wangjiacheng121/pendulum-gravity-measurement/assets/photos/产品实物图.jpg

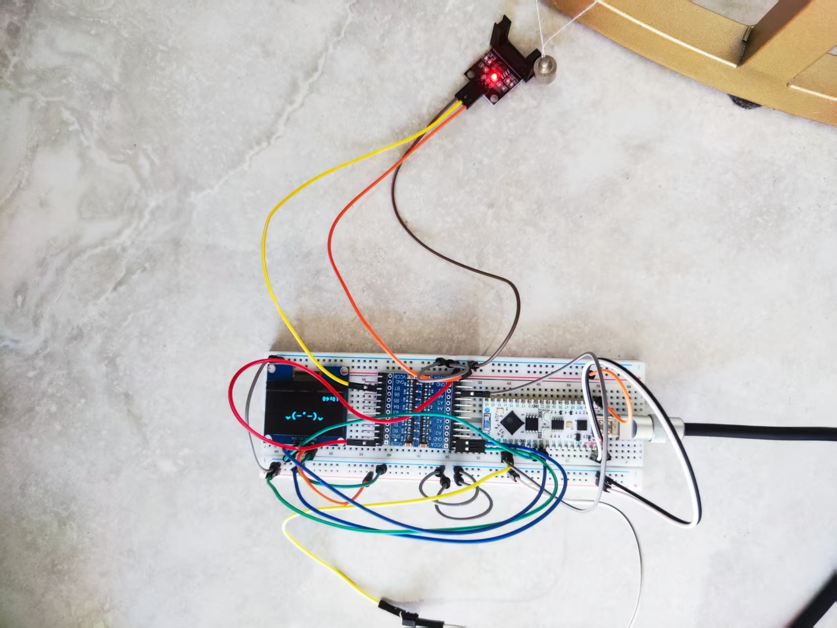
assets/photos/产品实物图.jpg
