wangjiacheng121/pendulum-gravity-measurement/assets/photos/天气-风速.jpg

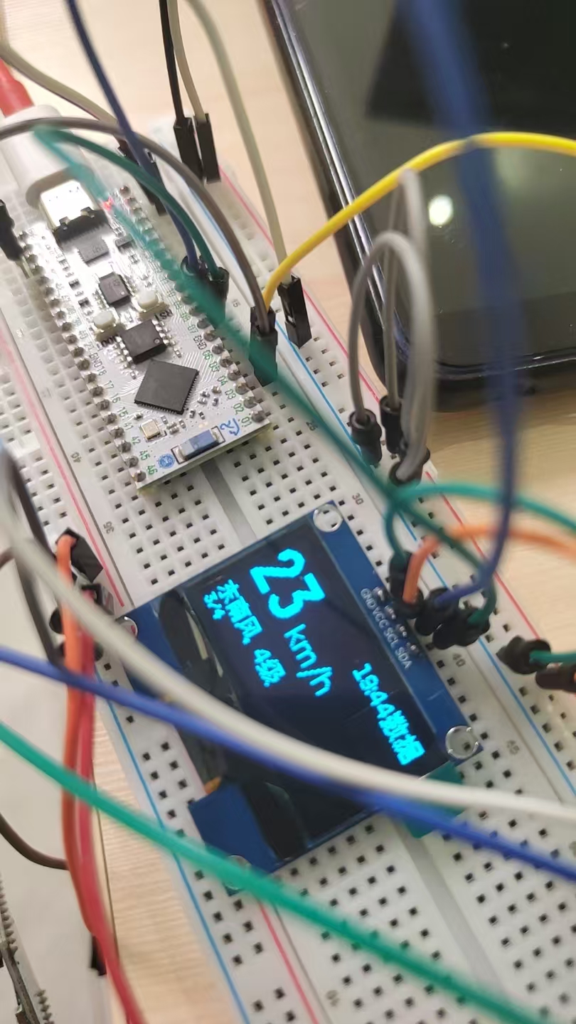
assets/photos/天气-风速.jpg
