wangjiacheng121/pendulum-gravity-measurement/hardware/3D打印外壳图纸（嘉立创X树脂免费打样）.html

# 3D打印外壳图纸（嘉立创 X 树脂免费打样版）

配套项目：单摆测重力加速度（ESP32S3 + 1.3" 屏 + 按键 + Type-C） | 生成日期：2026-10-06 | 建模方式：参数化脚本 enclosure/model_enclosure.py（全部在 E 盘，零 C 盘占用）

### 结论速览

方案 | 件数 | 单件包围盒 | 单件体积 | ≤100mm | ≤70cm³ | 组装难度 | 所需免费券
A 两分体（沿长度中缝对半） | 2 | 86×72×70 | 79.0 / 82.8 cm³ | ✓ | ⚠ 超 13~18% | ★ 最易（1 条缝） | 2 张（若订单页体积校验通过）
B 平板分件（6 面板按 ≤100mm 拆 10 块） | 10 | 最大 86×70×3 | 12.6 ~ 18.1 cm³ | ✓ | ✓ | 中（多缝胶接） | 5 张（每月助力可领）

建议：下单时先上传方案 A 的 2 个 STL，看订单页体积校验是否放行（X 树脂免费券不同时期限额不同，港澳站公示为 ≤150cm³）。若提示体积超限，改用方案 B（10 块全部双达标，按下面分组分 5 单下）。

## 一、总体尺寸与坐标系

项目 | 尺寸 (mm)
外尺寸 | 172 (X 前后) × 72 (Y 左右) × 70 (Z 高)
内腔 | 166 × 66 × 64
壁厚 | 3
顶板 / 底板 | 166 × 66 × 3（内腔投影，嵌于四壁之间）
前 / 后板 | 172 × 70 × 3（通长，厚 3）
左 / 右板 | 66 × 70 × 3（嵌于前后板之间）

坐标约定：X=0 为前面板外表面，Y=0 为左，Z=0 为底；面板之间为对接（无重叠），角部正好严丝合缝。

## 二、开孔明细（含孔位假设，请核对）

开孔 | 所在板 | 孔尺寸 | 定位方式 | 说明
1.3" 屏幕口 | 顶板（左半） | 36 × 35，R2 | 孔中心距顶板左边 32、距顶板前边 33 | 顶板左/前边指与左墙/前墙相接的边（全局 X=3 / Y=3 处）
按键杜邦过孔 ×2 | 顶板（左半） | Φ3.5 通孔 | 间距 2.54（杜邦标准），中心与屏幕口对齐，距顶板前边 10 | 两个公对母杜邦线分别穿过，按键置于壳外
Type-C 口 | 右板 | 9.5 × 3.8，R1.5 | 孔边缘距右板前边 33、距底边 15 | 9.5 沿水平方向，3.8 沿高度方向

⚠ 孔位假设说明（重要）： ① 屏幕口"距左 32 / 距前 33"若按孔边到板边计算，则 32+35=67 > 顶板宽 66，会切穿板边——因此按孔中心定位（中心距边 32/33），刚好居中偏前，与实物布局一致；若你实测屏幕模块位置不同，改脚本里 SCR_CX/SCR_CY 重跑即可。 ② 按键过孔位置为合理假设（屏幕正前方），可在脚本 BTN_Y 处调整。 ③ Type-C 口按孔边缘定位（33/15 均可放下，无冲突）。

## 三、方案 A：两分体（推荐优先尝试）

沿 X=86（长度正中）把壳体切成左右两个"开口托盘"，各含半截前/后墙 + 一整面端墙 + 半块顶/底板。两件对缝用 502 或环氧胶接即成完整壳体。

图 1 方案 A 分体示意（俯视）：沿 X=86 切成两个开口托盘

零件 | 文件 | 包围盒 (mm) | 体积 | ≤100×100×100 | ≤70cm³
左托盘（含屏幕口+按键孔） | stl/shell_left_tray.stl | 86 × 72 × 70 | 79.03 cm³ | ✓ | ✗ 超 9.03
右托盘（含 Type-C 口） | stl/shell_right_tray.stl | 86 × 72 × 70 | 82.75 cm³ | ✓ | ✗ 超 12.75

适用条件：X 树脂免费券若按 ≤150cm³（港澳站公示口径）则两件可直接免单；若订单页校验按 ≤70cm³ 拦截，请改用方案 B。

## 四、孔位图纸

### 4.1 顶板俯视图（166 × 66，下边 = 前面）

图 2 顶板孔位（对应零件 fp_top_L / 左托盘顶板部分）

### 4.2 右板视图（66 宽 × 70 高，左边 = 前面）

图 3 右板 Type-C 孔位（对应零件 fp_right / 右托盘右墙）

## 五、方案 B：平板分件（严格满足 ≤70cm³）

6 块面板中 4 块超长（166/172 > 100mm），各沿 X=86 一分为二，共 10 块平片，对接胶接。每块都是简单平板，打印成功率高、无支撑或极少支撑。

# | 零件 | 文件 | 尺寸 (mm) | 体积 (cm³) | 开孔

1 | 前面板·左 | fp_front_L.stl | 86 × 3 × 70 | 18.06 | —
2 | 前面板·右 | fp_front_R.stl | 86 × 3 × 70 | 18.06 | —
3 | 后面板·左 | fp_back_L.stl | 86 × 3 × 70 | 18.06 | —
4 | 后面板·右 | fp_back_R.stl | 86 × 3 × 70 | 18.06 | —
5 | 底板·左 | fp_bottom_L.stl | 83 × 66 × 3 | 16.43 | —
6 | 底板·右 | fp_bottom_R.stl | 83 × 66 × 3 | 16.43 | —
7 | 顶板·左 | fp_top_L.stl | 83 × 66 × 3 | 12.61 | 屏幕口 + 按键孔×2
8 | 顶板·右 | fp_top_R.stl | 83 × 66 × 3 | 16.43 | —
9 | 左板 | fp_left.stl | 3 × 66 × 70 | 13.86 | —
10 | 右板 | fp_right.stl | 3 × 66 × 70 | 13.76 | Type-C 口

### 下单分组建议（每券限 2 款 × 1 件、总体积 ≤70cm³）

订单 | 零件 | 合计体积 | 合规
第 1 单 | 前面板·左 + 右 | 36.12 cm³ | ✓
第 2 单 | 后面板·左 + 右 | 36.12 cm³ | ✓
第 3 单 | 顶板·左 + 右 | 29.04 cm³ | ✓
第 4 单 | 底板·左 + 右 | 32.86 cm³ | ✓
第 5 单 | 左板 + 右板 | 27.62 cm³ | ✓

每月可通过邀请助力领取 1 张免费券（首次无条件领 1 张），5 张券分 5 个月打完；也可先打顶板+右板（含全部开孔）验证孔位，再打其余。

## 六、嘉立创设计规范核对表

检查项 | 官方要求（X 树脂 / SLA） | 本设计 | 结论
单模型包围盒 | ≤ 100×100×100 mm | A: 86×72×70 B: 最大 86×70×3 | ✓ 全部通过
订单体积 | ≤ 70 cm³（不同时期口径可能为 150） | B 每单最大 36.1；A 单件 79~83 | B 通过 / A 视口径
壁厚 | 推荐 ≥2mm，紧固/卡扣 ≥1.5mm | 全部 3mm | ✓
最小孔径 | ≥1.5mm（喷油件 ≥2mm） | 最小为按键 Φ3.5 | ✓
孔公差 | 树脂 ±0.3mm（孔收缩变小） | Type-C 9.5×3.8 相对母座 ~8.94×3.26 已留 0.5+ 余量 | ✓
溢料孔 | 封闭空腔需 ≥2.5mm 溢料孔 | 开放壳体，无封闭空腔 | ✓ 不适用
拼接件规则 | 连接杆壁厚 >1.5mm、<10 件、每件 +0.5 元 | 方案 B 为 10 件分单下单，非同文件拼接 | ✓ 不触发加收
一文件一零件 | 强烈建议 | 12 个 STL 每文件 1 零件 | ✓
模型类型 | 机电产品结构件、原创 | 自制项目外壳，参数化原创 | ✓

## 七、装配与使用说明

- 胶接：对接面用 502（快固）或环氧 AB 胶（强度高）。建议先干拼一遍确认孔位朝向，再点胶。装配顺序：前后墙 + 左右墙围框 → 底板 → 顶板（方案 B）；方案 A 直接两托盘对缝胶接。
- 屏幕：1.3" 屏从壳内对准 36×35 R2 窗口，热熔胶/支架固定即可；孔边距约 15mm 有足够粘接面。
- Type-C：孔 9.5×3.8 已含 R1.5 圆角并预留 0.5mm 以上余量；若插头偏紧，用小刀/锉轻扩即可（树脂孔收缩 ≤0.3）。
- 按键：两根公对母杜邦线从顶板 2×Φ3.5 孔穿出，按键置于壳外；孔距 2.54mm 与杜邦插头间距一致。
- 打印摆放：平片类零件以大面朝下（贴热台）打印，变形最小；托盘件开口朝上。
- 修改再生成：所有尺寸/孔位集中在 enclosure/model_enclosure.py 顶部参数区（SCR_CX/SCR_CY 屏幕中心、BTN_Y 按键位置、SPLIT 切缝位置等），改完运行：

cd E:/Users/2026-09-24-18-32-24/enclosure && ./.venv/Scripts/python.exe model_enclosure.py

## 八、文件清单

路径 | 内容
enclosure/stl/shell_left_tray.stl | 方案 A · 左托盘（屏幕口+按键孔）
enclosure/stl/shell_right_tray.stl | 方案 A · 右托盘（Type-C 口）
enclosure/stl/fp_*.stl | 方案 B · 平板分件 10 块
enclosure/外壳STL打包.zip | 以上 12 个 STL 的打包（直接上传嘉立创）
enclosure/model_enclosure.py | 参数化建模脚本（改参数重跑即可）
enclosure/report.json | 尺寸/体积/水密性机检报告

免费打样下单入口：m-3dp.jlc.com → 上传 STL → 材料 X 树脂 → 选择免费券。免费件会有嘉立创生产标识（打在模型内侧平面，不影响外观）。
