wangjiacheng121/pendulum-gravity-measurement/firmware/TaskManagerFirmware/docs/README.md

# 固件文档索引

本目录包含每个程序的独立说明文档。快速导航：

| 文档 | 程序 | 核心内容 |
|---|---|---|
| [程序1-桌宠.md](程序1-桌宠.md) | 桌宠屏保 | 表情状态机 / 事件联动 / AI+RSS 预留 |
| [程序2-单摆测g.md](程序2-单摆测g.md) | 单摆测g | 中点法计时 / 四行布局 / **实时波形 #STREAM 协议** / 原版对照 |
| [程序3-天气.md](程序3-天气.md) | 实时天气 | QWeather v7 / 四屏显示 / 紧凑缓存 / 自动重连 |

## 公共基础设施文档

| 文档 | 内容 |
|---|---|
| [../README.md](../README.md) | 固件总览：环境/文件结构/按键/BLE/已知取舍 |
| [../tools/README.md](../tools/README.md) | PC 端工具：ble_cli（命令行+导出）+ phyphox_stream（实时波形）|
