wangjiacheng121/pendulum-gravity-measurement/tools/mobile-webui/使用说明.txt

pendulum-g 手机端蓝牙终端 · 使用说明
（ble_cli.py 网页版 / HyperOS + Operit 适用 / 2026-10-02）

━━━━━━━━━━━━━━━━━━━━━━━━━━━━━━━━━━
一、包内容（共 3 个文件）
━━━━━━━━━━━━━━━━━━━━━━━━━━━━━━━━━━
  ble_cli_web.html   主工具（网页版蓝牙终端，零依赖，无需安装任何 App）
  启动服务.sh         一键启动本地服务（在 Operit 终端运行）
  使用说明.txt        本文件

━━━━━━━━━━━━━━━━━━━━━━━━━━━━━━━━━━
二、重要原理（30 秒读完，避免走弯路）
━━━━━━━━━━━━━━━━━━━━━━━━━━━━━━━━━━
  Operit 的 Ubuntu 是 chroot/proot 容器，没有蓝牙控制器访问权，
  所以 python + bleak（ble_cli.py）在手机上跑不了，root 也无解。
  本工具改用 Chrome 的 Web Bluetooth：由 Chrome 直接调系统蓝牙，
  Operit 的 Ubuntu 只负责起一个本地网页服务。因此：

  * 必须用 Chrome / Edge 等 Chromium 内核浏览器（小米自带浏览器不行）
  * 必须通过 http://127.0.0.1:8000 打开（直接点开 html 文件不行）

━━━━━━━━━━━━━━━━━━━━━━━━━━━━━━━━━━
三、安装与启动（5 步）
━━━━━━━━━━━━━━━━━━━━━━━━━━━━━━━━━━
  1. 把整个「手机端工具包」文件夹拷到手机存储
     （例如 Download/手机端工具包；若 Operit 终端访问不了
      sdcard 路径，就把文件夹复制进 Operit 工作区目录）

  2. 打开 Operit → 终端（Ubuntu），执行：
        cd /你的路径/手机端工具包
        sh 启动服务.sh
     出现 "pendulum-g 本地服务已启动" 即成功。
     （若提示 python3 不存在：apt update && apt install -y python3）

  3. 打开 Chrome，地址栏输入：
        http://127.0.0.1:8000/ble_cli_web.html
     （服务开着才能访问；可收藏此地址）

  4. 开发板上电。点页面顶部「连接 pendulum-g」，
     在系统弹窗里选中 pendulum-g 设备。

  5. 之后所有操作在「终端」卡片进行，和 PC 版 ble_cli.py
     完全一样——看板子的提示输出，照着输入即可。

━━━━━━━━━━━━━━━━━━━━━━━━━━━━━━━━━━
四、常用操作对照（与 PC 版一致）
━━━━━━━━━━━━━━━━━━━━━━━━━━━━━━━━━━
  看状态        0
  配网          1 → 看WiFi列表输序号 → 输密码
  摆长          2 → 2.1 查看 / 2.2 修改（输值后 y 确认）
  海拔          2 进会话后：alt 500
  历史预览      3 → 3.1
  历史导出      3 → 3.2 → 自动收数+自动下载 Excel+T²-L 图
  历史清空      3 → 3.3 → 输 CLEAR
  天气设置      4 → 4.1 状态 / 4.2 坐标 / 4.3 更新 / 4.4 Key+Host
  切程序        APP 1（桌宠）/ APP 2（单摆）/ APP 3（天气）
  模拟自测      APP 2 → SIM ON（结束 SIM OFF 自动入库）
  实时波形      APP 2 → 点「STREAM ON」→ 板上短按键开始测量
  退出会话      q
  （快捷按钮在终端输入框下方，点一下=自动发送）

━━━━━━━━━━━━━━━━━━━━━━━━━━━━━━━━━━
五、文件去哪了
━━━━━━━━━━━━━━━━━━━━━━━━━━━━━━━━━━
  Excel / CSV / T²-L 图 PNG：手机「下载 / Download」目录
  文件名格式：pendulum_history_时间.xlsx、pendulum_T2L_时间.png

━━━━━━━━━━━━━━━━━━━━━━━━━━━━━━━━━━
六、常见问题
━━━━━━━━━━━━━━━━━━━━━━━━━━━━━━━━━━
  Q: 打开网页提示无法访问？
     启动服务.sh 必须保持运行。终端被关了就重新执行第 2 步。

  Q: 点连接没反应/不支持？
     确认用的是 Chrome；系统设置→应用→Chrome→权限→
     「附近设备」设为允许。

  Q: 扫不到 pendulum-g？
     板子重新上电；确认没被 nRF Connect 等 App 占用。

  Q: 连上但终端没输出？
     随便发一个 0 试试。

  Q: 波形卡顿/断流？
     保持 Chrome 页面在前台；给 Chrome 的省电策略设为「无限制」。
     页面会自动申请屏幕常亮，勿手动锁屏。

  Q: 导出中途断了？
     20 秒收不到数据会自动按已收到的部分保存（和 PC 版一样），
     重新发 3.2 即可重导。

━━━━━━━━━━━━━━━━━━━━━━━━━━━━━━━━━━
七、停止
━━━━━━━━━━━━━━━━━━━━━━━━━━━━━━━━━━
  终端里按 Ctrl+C 停服务；页面点「断开」退蓝牙。
  服务不用时建议关掉（省电）。
