wangjiacheng121/pendulum-gravity-measurement/firmware/TaskManagerFirmware/docs/程序2-单摆测g.md

# 程序2：单摆测g（AppId::PENDULUM）

## 概述

核心物理实验程序——通过光电门中断计时测量单摆周期，计算重力加速度 g，支持历史记录、BLE 配置和**实时波形推送（phyphox 兼容）**。

## 计时法：中点法（2026-09-30 升级，2026-10-03 采集/重建分层）

| 项目 | 说明 |
|---|---|
| 触发方式 | GPIO4 中断 **CHANGE 双沿**（FALLING 进遮挡 / RISING 出遮挡）|
| 计时点 | **遮挡时段中点** = `t_in + (t_out - t_in) / 2` |
| 有效数据 | 相邻中点差 = **半周期** |
| 基准管理 | 首个中点仅建立基准不计数；中点差 >5s 重置基准 |
| 精度 | micros() µs 级计时；临界区 noInterrupts 保护 |

> 详见《02-程序2-单摆测g-中点法修订补丁.md》

### 采集 / 重建分层（2026-10-03 重大改造）

改造前 ISR 一边记时间戳一边做判决并丢弃，导致**丢样不可逆**：门限一旦杀掉样本，
loop 层拿不到任何信息，既无法恢复也无法定位。改造后职责彻底拆开：

| 层 | 位置 | 职责 | 是否丢数据 |
|---|---|---|---|
| **采集层** | `gateISR()` | 只做一件事：把每条边沿（亮/灭）连同时间戳写进环形队列 | **绝不丢弃**（唯一例外：队列溢出会计数上报）|
| **重建层** | `onTick()` | 边沿 → 遮挡片段 → 过零中点，并执行全部纠错 | 剔除的都计数留账 |

因此「每一次光电门亮起或熄灭都被记录为有效数据」在结构上成为保证，
而不是一句承诺 —— `EDGES` 命令可逐条导出原始边沿现场核对。

#### 门限（全部以半周期标尺 hRef 为单位，不用绝对微秒数）

| 门限 | 值 | 含义 | 为何这样取 |
|---|---|---|---|
| `GATE_BLINK_MIN_US` | 20 µs | 电气尖峰下限 | 真实电气毛刺 1–10 µs、真实遮挡 ≥4 ms，20 µs 两侧都是空区 |
| `PEND_MINGAP_REL` | 0.30 × hRef | 相对下限 / 碎片合并判据 | 半周期是本实验唯一时间尺度，远小于它的不是独立摆动 |
| `PEND_OUTLIER_REL` | 0.25 × hRef | 离群删除 | 需容纳光电门偏离最低点带来的 ±8% 快慢交替 |
| `PEND_INT_TOL` | ±8% | 整数倍判定 | 判定「这个间隔里漏了 m−1 次」 |
| `PEND_FIX_TOL` / `MAXK` | ±10% / m≤4 | 系统性倍率纠正 | 只做缩小周期方向（丢样只会让周期变大，方向上无歧义）|

> 绝对微秒门限在 L 可变（0.1–5 m ⇒ 半周期 0.63–4.5 s）的实验里必然要么太松要么太紧，
> 故除电气尖峰外一律改用相对判据。

#### 纠错能力（对应「恢复被舍去的数据 / 删除明显不符合规律的数据」）

| 机制 | 触发条件 | 动作 | 对 g 的影响 |
|---|---|---|---|
| **碎片合并** | 与上一片段间隔 < 0.30×hRef | 判为同一次过零的碎片，中点按时长加权合并，计数不虚增 | 中点=整段几何中心，零偏差 |
| **整数倍恢复** | d ≈ m×hRef（m≥2）| 认定中间漏了 m−1 次，`n` 补 m−1，**时间守恒** | **无影响**（sumHalf 加同一段真实时间）|
| **离群删除** | \|d−hRef\|/hRef > 0.25 | 删单个样本（不删整对，避免配对留空洞）| 剔除异常点 |
| **系统性倍率纠正** | 实测 T ≈ m×理论T（m=2..4）| 按 1/m 折算周期，OLED 挂 `FIXx2` 角标 | 修正 g |
| **摆长疑似错** | 实测 h 与理论 h 偏差 >40% | 标尺回退到理论值，每 2s 串口提示核对单位 | 只提示，不擅自改 L |

> 自动纠正过的 g 一定在屏幕上带 `FIXxN` 角标 —— 让用户知道这个数字被软件折算过，
> 而不是让一个改过的值冒充实测值。摆长填错则**绝不**当成丢样去纠正（会掩盖真因）。

#### 新增命令（串口与 BLE 同语义）

| 命令 | 功能 |
|---|---|
| `GATE` / `GATE RESET` | 采集层体检：边沿数 / 溢出 / 遮挡片段 / 碎片合并 / 剔除 / 各类恢复 |
| `FIX` | 纠错账目：收了多少、剔了多少、恢复了多少、删了多少、纠正了几次，偏差来自丢样还是摆长 |
| `EDGES` | 原始边沿逐条转储（时刻 + 电平），用于验证零丢弃 |

> 排障第一入口仍是 `GATE`：边沿数只增不减、永不判决，
> 因此「硬件到底有没有看到摆动」从此有一个不受任何软件判据影响的纯净答案。

## OLED 四行布局

```
  g=9.812 m/s²          ← 即时 g（最近一个周期）
  n=24  t=2.007s         ← 本次测量累计半周期数 + 最近周期 T
  L=1.000 sG=9.794       ← 摆长 + 当地标准 g
  N=24  G=9.801           ← 本次测量累计半周期数（与 n 同值）+ 平均 G
  err=0.07%              [测量中]     ← 相对误差 + 状态
```

## BLE 菜单

### [2] 摆长 / 波形

| 命令 | 功能 |
|---|---|
| 2.1 | 查看当前摆长 L |
| 2.2 | 修改摆长（0.1–5.0 m，二次确认 y/n）|
| **2.4** | **实时波形：STREAM ON / OFF 切换** |
| q | 退出子菜单 |

> **顶层别名**：`STREAM ON` / `STREAM OFF` 可**不进任何会话直接发送**（PC 波形工具 's' 键即走此路径）；程序2 非活跃时固件拒绝并提示「请长按切到 [2]」，此时客户端本地状态自动回退。

### [3] 历史数据

| 命令 | 功能 |
|---|---|
| 3.1 | 预览最新一条 |
| 3.2 | 导出全部（#EXPORT 协议，PC 端自动存 Excel + 绘 T²–L 图）|
| 3.3 | 清空（需键入 CLEAR 确认）|

### 隐藏命令（摆长会话内）

| 命令 | 功能 |
|---|---|
| `alt 123.4` | 修改海拔高度（米），影响当地标准 g 计算 |
| `altstat` | 快慢交替诊断（判断光电门是否偏离最低点）|
| `GATE` | 采集层体检（边沿/片段/碎片合并/剔除/溢出）|
| `FIX` | 纠错账目（恢复/删除/倍率纠正）|
| `EDGES` | 原始边沿转储（验证零丢弃）|

> `GATE` / `FIX` / `EDGES` 同时是**顶层命令**，不进会话直接发即可。

### 模拟数据（无光电门自测，R5 新增）

> **用途**：未接光电门/摆时，用已知周期的合成数据跑通「测量→计算→导出→PC 绘图」全链路，
> 验证固件与 PC 工具，而非验证物理。
> 2026-10-03 起注入的是**边沿对**（LOW → simBlkUs → HIGH）而非成品样本，
> 与真实硬件走完全相同的采集→重建→纠错路径，因此 SIM 验的是真实代码链路而非绕过它。

| 命令 | 功能 |
|---|---|
| `SIM ON` | 开启模拟数据（自动切到测量中）。默认按 L 与 g=9.80 反算半周期，使测出 Gavg≈9.80，便于核对 |
| `SIM <秒>` | 自定义半周期（0.05–10.0 s），如 `SIM 1.5` |
| `SIM OFF` | 停止模拟并结算（写入一条历史），恢复待机 |

> 前置：必须处于 [2] 单摆测g 前台（onTick 仅在活跃程序运行）。无按键时可用系统调试命令
> `APP 2` 经 BLE 切换（走 Manager 正规 activate 路径，与长按等价；见下）。开启后配合 `STREAM ON` 可测 PC 波形端到端。

### 系统调试命令（R5 新增，fw_ble 顶层）

| 命令 | 功能 |
|---|---|
| `APP <1\|2\|3>` | BLE 远程切换程序（调试用；设计上切程序本应只走按键长按，此命令为无按键调试开放，生命周期钩子完整触发） |

## 实时波形功能（phyphox 兼容）

### 启动条件（全部满足才推送）

1. 程序2 为当前活跃程序
2. 处于测量中状态（已按短键开始）
3. BLE 已连接
4. 客户端已发送 `STREAM ON`

### 协议

```
客户端 → 固件:  STREAM ON
固件 → 客户端:  #STREAM BEGIN
固件 → 客户端:  #STREAM 1,2007000,2.007000,9.8123,9.8012,24,1.000
固件 → 客户端:  #STREAM 2,2010000,2.010000,9.7826,9.7965,25,1.000
              ...
客户端 → 固件:  STREAM OFF
固件 → 客户端:  #STREAM END
```

### 字段定义

| 字段 | 类型 | 示例 | 说明 |
|---|---|---|---|
| seq | int | 1 | 帧序号（单调递增）|
| dt_us | int | 2007000 | 半周期原始值（µs）|
| T | float | 2.007000 | 周期 T = 2 × halfT（秒）|
| g_inst | float | 9.8123 | 即时 g = 4π²L/T² |
| g_avg | float | 9.8012 | 平均 g = 4π²L/Tavg² |
| n | int | 24 | 累计半周期数 |
| L | float | 1.000 | 当前摆长（m）|

### 自动停止条件

- 客户端发送 `STREAM OFF`
- 测量结束（用户再按短键停止）
- 切换到其他程序（长按）
- BLE 断连

### PC 客户端

```bash
cd tools
python phyphox_stream.py        # 自动扫描连接
# 按 s 开始/停止波形
# 按 e 导出 CSV
# 按 q 退出
```

详见 `tools/README.md` §工具二

## NVS 键

| 键 | 类型 | 默认值 | 说明 |
|---|---|---|---|
| app2.pend_len | double | 1.000 | 摆长（m）|
| app2.sg_cache | double | 9.794 | 当地标准 g 缓存 |
| app2.sg_src | string | "DEFAULT" | g 来源：DEFAULT（无缓存出厂默认）/ CALC（本地国际重力公式计算，含联网改坐标后重算）|
| app2.sg_ts | int32 | 0 | g 缓存时间戳（epoch）|
| app2.alt_m | double | 0.0 | 海拔（m），影响 g 计算 |
| app2.hist_00..49 | string | — | 历史记录环形区（最多 50 组 CSV）|

## 当地标准 g 计算

国际重力公式：
```
g = 9.780327 × (1 + 0.0053024·sin²φ − 0.0000058·sin²2φ) − 3.086×10⁻⁶ × h
```
- φ = 纬度（默认 40.77° 张家口一中，NVS `sys.loc_lat`）
- h = 海拔（m，NVS `app2.alt_m`）

## 文件

- `app2_pendulum.h` —— 类声明、BleState 枚举、流状态成员
- `app2_pendulum.cpp` —— ISR 中断处理机 / 生命周期 / 测量结算 / BLE 菜单 / 流推送

## 测量误差与操作约束（2026-10-02 数值核算）

### 1. 光电门不在最低点：单次误差大，但快慢成对平均后抵消

设光电门相对最低点水平偏移 x₀，摆幅 ±A，相邻两次过门中点间隔为

```
半周期 = T/2 ∓ (2/ω)·asin(x₀/A)      ω = 2π/T
```

即**一次偏短、一次偏长，符号相反**（L=1 m、振幅 ±5 cm 实算）：

| 偏移 x₀ | 快向半周期 | 慢向半周期 | 单次 g 偏差 | n=2（成对）| n=3 | n=4 |
|---|---|---|---|---|---|---|
| 3 mm | 0.965 s | 1.042 s | +8.1% / −7.2% | **0.00%** | +2.6% | **0.00%** |
| 5 mm | 0.940 s | 1.068 s | +14.1% / −12.3% | **0.00%** | +4.4% | **0.00%** |
| 8 mm | 0.901 s | 1.106 s | +24.1% / −17.7% | **0.00%** | +7.2% | **0.00%** |
| 12 mm | 0.849 s | 1.158 s | +39.8% / −25.0% | **0.00%** | +11.1% | **0.00%** |

**结论：只要 n 为偶数（快慢成对），Tavg 与 g 的偏差理论上为 0。** 固件的
`_sumHalf/_nHalf` 天然满足这一点（每个半周期都入队累加）。

**但有两个真实风险：**

- **n 为奇数或中途丢样本** → 剩余样本不成对，误差直接残留（n=1 时偏 14%）。
  短摆（L=0.1 m，半周期仅 0.32 s）若 OLED 整帧提交拖长 tick 会丢样本，
  务必让 n 停在偶数、或干脆用 T²–L 多点拟合（PC 端 `e2e` 已实现）取斜率。
- **偏移过大（≥ 摆幅）** → 摆球单向通过，光电门每周期只触发一次，
  此时「相邻中点差 = 一个完整周期」，而固件按半周期处理 → g 偏大约 4 倍。
  **务必保证偏移 ≪ 振幅。**

### 2. 有限振幅非线性：真正的系统偏差，与光电门位置无关

| 振幅角 | 横向摆幅(L=1m) | g 偏差 |
|---|---|---|
| 3° | 5.2 cm | −0.034% |
| 5° | 8.7 cm | −0.095% |
| 8° | 13.9 cm | −0.24% |
| 10° | 17.4 cm | −0.38% |
| 15° | 25.9 cm | −0.85% |

近似 −θ₀²/8。**操作要求：横向摆幅控制在 5 cm 以内（≤3°）**，
既保证非线性误差 <0.05%，也保证偏移/振幅比足够小。

### 3. 操作要点

- 光电门装在**最低点**（对不准也要保证偏移 < 5 mm）
- 横向振幅 ≤ 5 cm，不要甩大圈
- 摆长 L 用细线量到**摆球摆心**（含挡光片中心高度）
- 测完一组检查 n：偶数可直接采信，奇数建议重测
- 追求高精度时用 PC 端 T²–L 线性拟合（多点取斜率，单点系统性偏差被摊薄）

## 与原版 Rust 仓库对照

| 维度 | 原版（mcitem/pendulum-gravity-measurement）| 本固件 |
|---|---|---|
| 语言/框架 | Rust + Embassy + esp-hal | Arduino C++ / ESP32 core 3.x |
| 计时法 | 中点法（双沿配对取遮挡中点）| **一致**（2026-09-30 升级对齐）|
| 数据推送 | 自定义 phyphox GATT（f64 notify）| NUS #STREAM 文本协议 |
| 本地历史 | 无 | NVS 50 组环形 + Excel 导出 |
| 当地 g | 无 | 国际重力公式 + 联网缓存 |
| 多程序 | 独立固件 | 任务管理器三程序合一 |

## g 值异常排查：丢样诊断（2026-10-02 新增）

### 现象

用户实测 **g ≈ 1~2**，而理论值 9.794（L=0.425m，张家口）。摆长输入 0.425 正确。

### 数值反推（定位依据）

L=0.425m → 理论半周期 h=0.654s、完整周期 T=1.309s。反推不同 g 对应的 Tavg：

| 实测 g | Tavg | Tavg / T |
|---|---|---|
| 1.0 | 4.096s | 3.13 |
| 1.5 | 3.344s | 2.56 |
| 2.0 | 2.896s | 2.21 |
| **2.448** | **2.618s** | **2.00** |

**g=2.448 恰好等于真实值的 1/4**，正落在用户观测的 1~2 区间。

### 机制

配对逻辑 `_pendHalf + halfT`（两半周期相加 = 一个整周期）**数学本身正确**，
所以 Tavg 偏大只可能是**中点事件丢失**：

```
应有：  h    h    h    h     (每 0.654s 一个事件)
实得：  丢   T    丢   T      (每 1.309s 一个被采纳)
配对：  T + T = 2T = 2.618s，被当作「一个周期」
       → g = 4π²L/(2T)² = 真实g/4 = 2.448
```

丢失率越高 g 越小，故 g 可以低到 1~2。

### 新增诊断计数器

ISR 内五个计数器（`resetMeasure()` 清零），结算时打印：

```
[ Pend ] 丢样诊断: 事件总数=N 入队=M | 短遮挡丢弃=A 过近丢弃=B 超时丢弃=C
[ Pend ] 周期核对: 理论半周期=X s 实测半周期=Y s 比值=R -> 正常/异常
```

| 计数器偏高 | 含义 | 处理方向 |
|---|---|---|
| `短遮挡丢弃` | 遮挡时长 <20ms 被判毛刺（`GATE_DEBOUNCE_US=20000µs`）| 挡光片太窄/摆球太快 → 加宽挡光片至 20mm+，或下调阈值 |
| `过近丢弃` | 相邻中点 <20ms，异常过近 | 存在抖动/双触发 → 检查接线与上拉 |
| `超时丢弃` | 相邻中点 >5s，基准失效 | 摆动中断/停顿，属正常 |
| `事件总数 ≈ 2×入队` | **隔次丢样确认** | 比值 ≈2 即本案 |

比值落在 0.55~1.8 之外时，屏幕弹出「周期异常,疑似丢样」通知。

### 注意

配对机制**不能**修正系统性丢样——它只能消除「快慢交替」和奇偶尾差。
一旦事件按固定倍数丢失，配对会把错误间隔照单全收。

## 上板实测：n 不增长的两个原因（2026-10-02 晚）

### 现象

用户反馈「单摆通过后显示的 n 没有增加，通过数次后才增加」。

### 排查结论：**不是 bug，是操作 + 一个真 bug**

**原因 A（操作）**：必须先**短按开始测量**。待机时 onTick 内 `if (!_measuring) continue;`
会把 ISR 捕获的样本全部丢弃，`n` 恒为 0——这是设计行为（避免待机时摆动把 OLED 拉成 10fps）。
屏幕右下角 `[待机]` / `[测量中]` 是唯一状态标识，容易被忽略。

**原因 B（真 bug，已修）**：L0 屏保在长按切程序后**立刻误触发**，把刚切过去的程序弹回桌宠：

```
[Btn] LONG 802ms fired
[Mgr] activate 单摆测g (4.0ms) reason=long-press     ← 已切过去
[Mgr] L0 screen-saver -> app1                          ← 又被弹回
[Mgr] activate 桌宠 (32.0ms) reason=screensaver
```

根因：`tick()` 开头的 `now` 早于 `handleButton()` 内 `activate()` 末尾的
`_lastInteract = millis()`（activate 要写 NVS + 整帧提交，耗时 1–33ms）。
屏保判据 `(uint32_t)(now - _lastInteract)` 于是**无符号下溢**成 ~4.29e9 > timeout，误判超时。
activate 耗时越长越必然触发（实测 1ms 那次侥幸未中，32ms 两次全中）。

修复（`fw_manager.cpp`）：
1. 屏保检查前用 `now = millis();` 重新取时间（必须在 handleButton 之后）
2. 判据改 `(int32_t)(now - _lastInteract) > (int32_t)_saverTimeoutS * 1000`（环绕安全）
3. 删掉长按分支里多余的 `_lastInteract = now`（activate 已正确赋值，留着反而写入偏旧值）

### SIM 模式验证（串口，排除硬件因素）

新增 `tools/serial_pend_n_test.py`。结果：

```
[ Pend ] 结算: n=33 参与=32(成对16组) Tavg=1.30846 Gavg=9.8000 交替=无 落单1个已排除
[ Pend ] 周期核对: 理论半周期=0.6542s 实测半周期=0.6542s 比值=1.000 -> 正常
```

`n` 24→30→33 持续增长、G=9.8000（err −0.02%）、周期核对比值 1.000 →
**固件测量链路完好**，此前 g≈1~2 与 n 不增长均为上述原因 A/B 所致。

### 新增防呆

待机时若检测到摆动事件，屏幕显示「请短按开始测量」4 秒（限频 1s 刷新，不影响测量态）。
