wangjiacheng121/pendulum-gravity-measurement/assets/photos/单摆测重力加速度实景.jpg

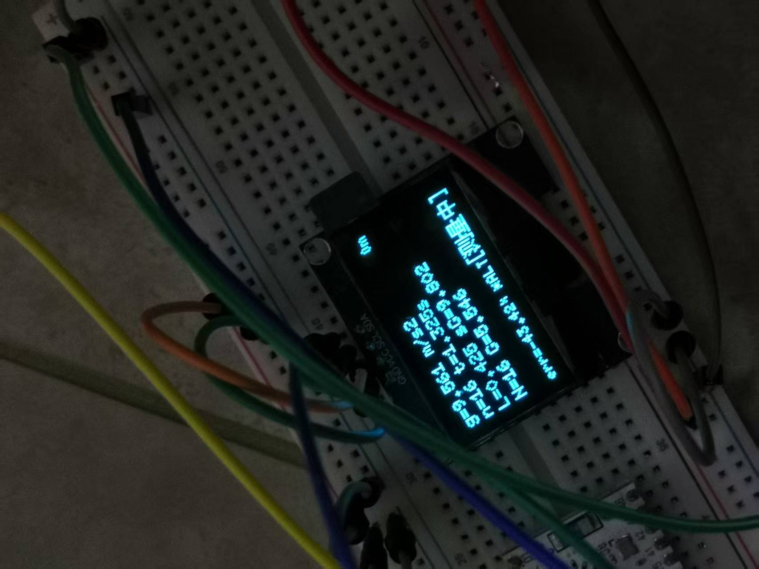
assets/photos/单摆测重力加速度实景.jpg
