wangjiacheng121/pendulum-gravity-measurement/assets/photos/单摆测重力加速度理想数据.jpg

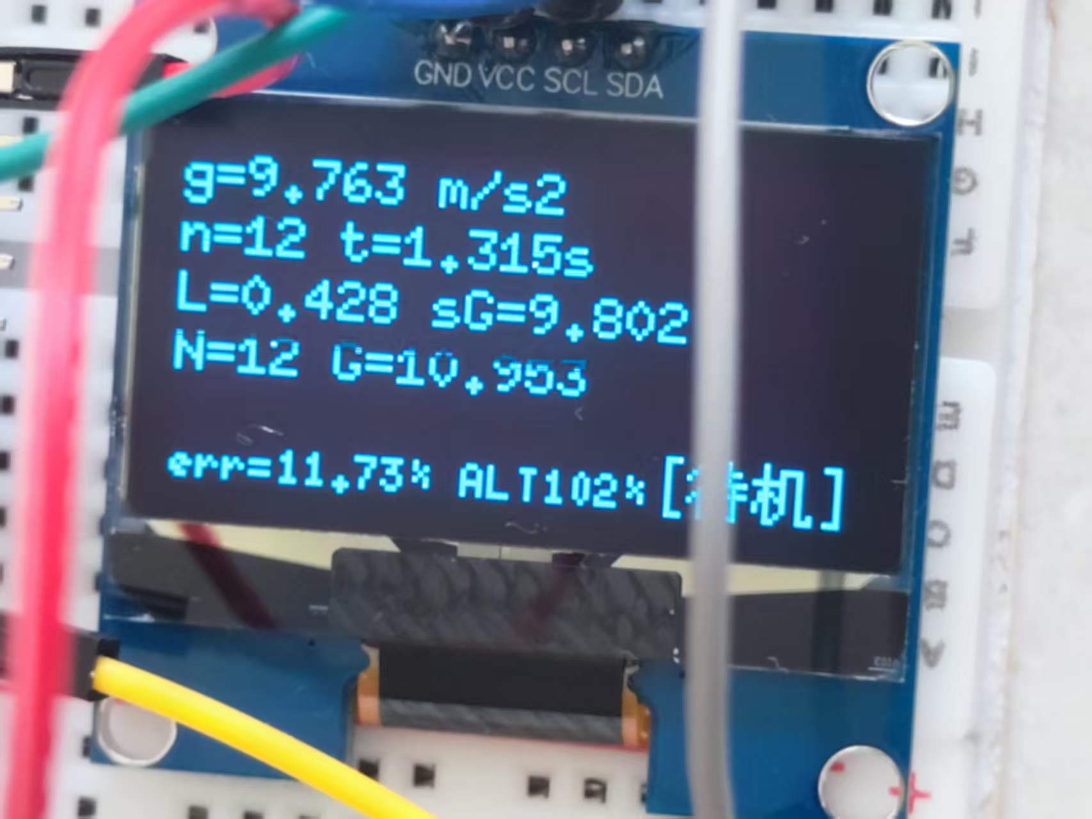
assets/photos/单摆测重力加速度理想数据.jpg
