wangjiacheng121/pendulum-gravity-measurement/assets/photos/天气-温度.jpg

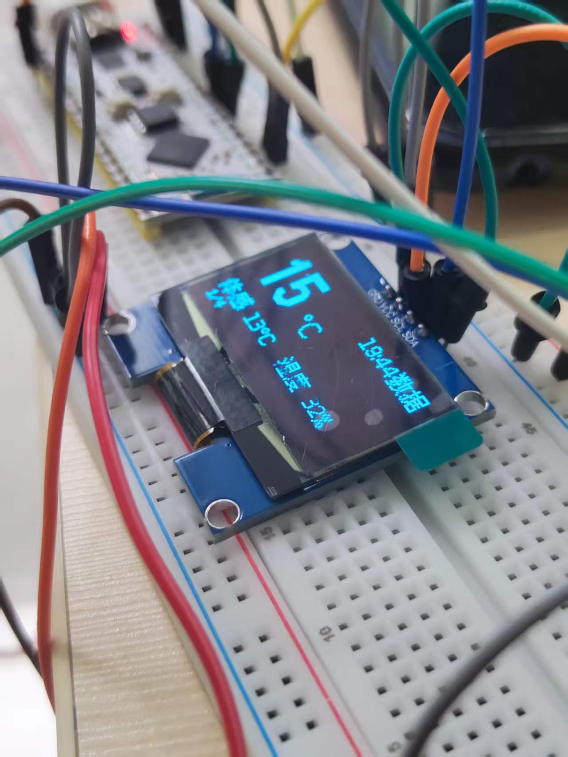
assets/photos/天气-温度.jpg
