wangjiacheng121/pendulum-gravity-measurement/assets/photos/天气-降水.jpg

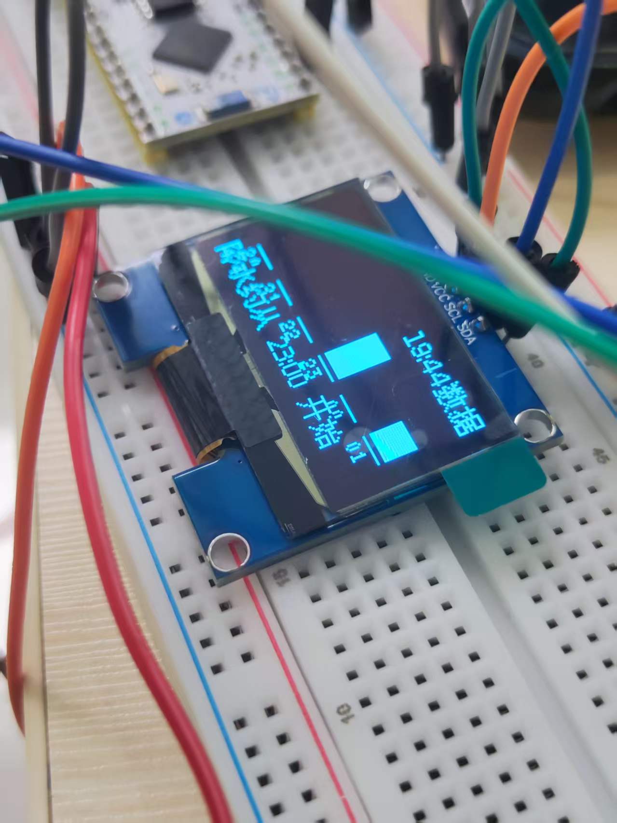
assets/photos/天气-降水.jpg
