wangjiacheng121/pendulum-gravity-measurement/assets/photos/桌宠-打盹.jpg

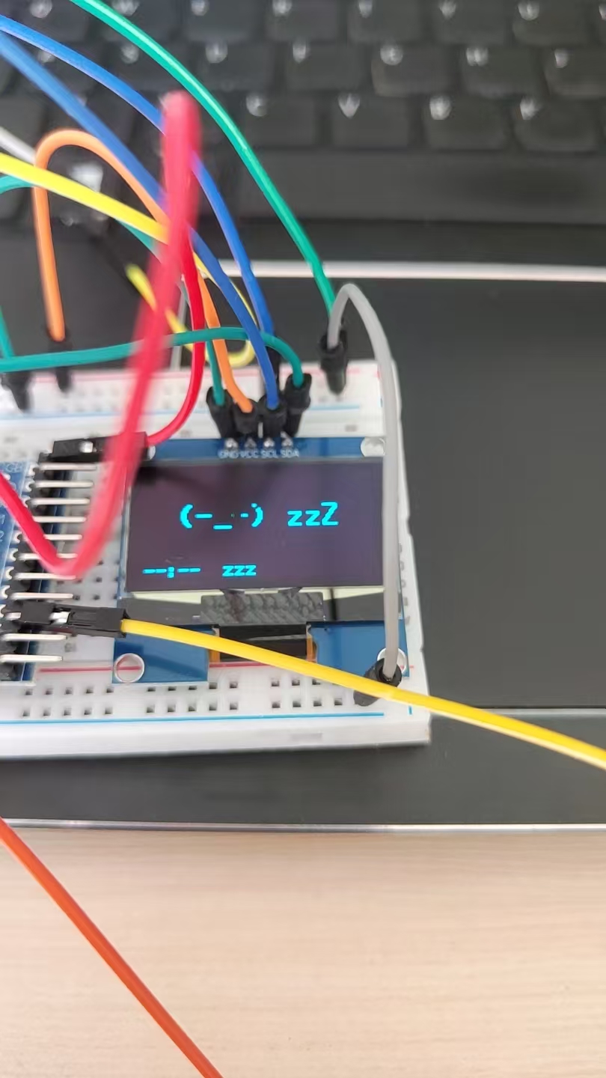
assets/photos/桌宠-打盹.jpg
