wangjiacheng121/pendulum-gravity-measurement/hardware/enclosure/stl/shell_assembled.stl

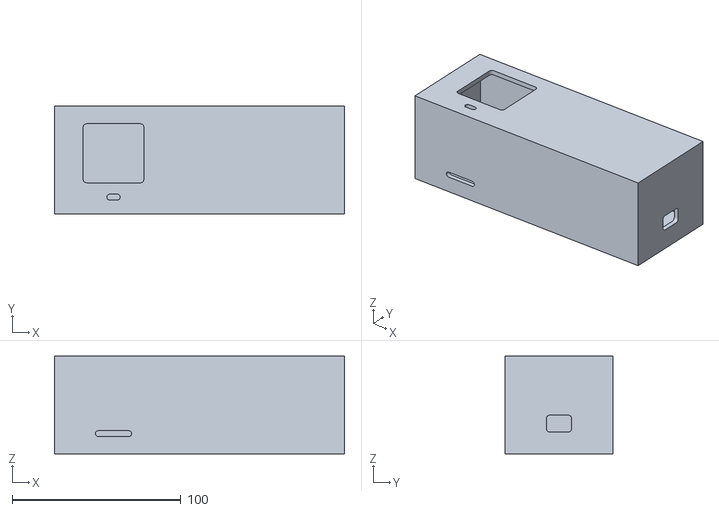
[picture p9: CAD file, 2026-10-17]
hardware/enclosure/stl/shell_assembled.stl
172.0 x 64.0 x 58.0
