wangjiacheng121/pendulum-gravity-measurement/hardware/enclosure/stl/shell_right_tray.stl

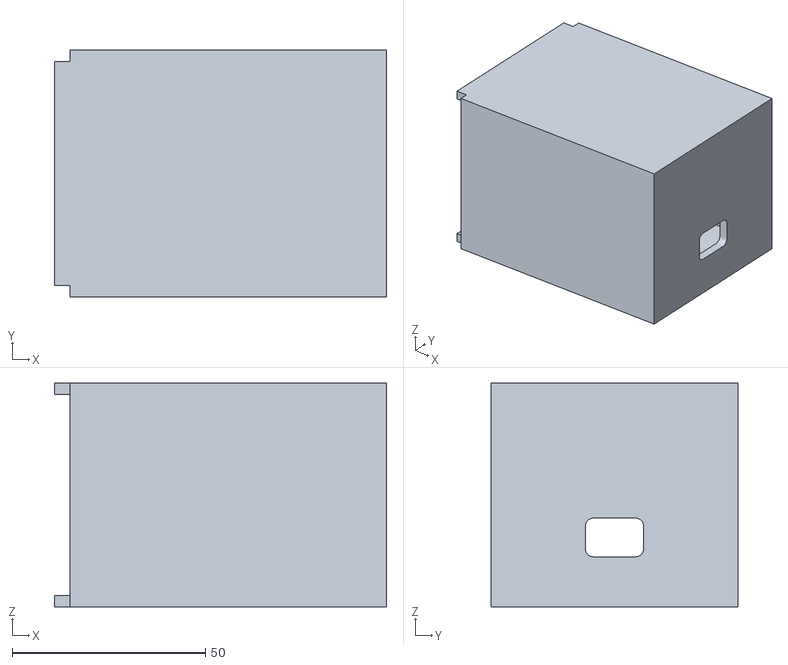
[picture p10: CAD file, 2026-10-17]
hardware/enclosure/stl/shell_right_tray.stl
86.0 x 64.0 x 58.0
