wangjiacheng121/pendulum-gravity-measurement/hardware/enclosure/stl/shell_left_tray.stl

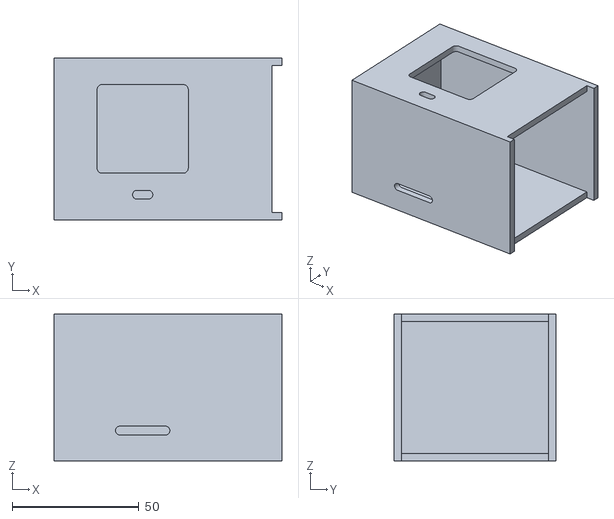
[picture p11: CAD file, 2026-10-17]
hardware/enclosure/stl/shell_left_tray.stl
90.0 x 64.0 x 58.0
