wangjiacheng121/pendulum-gravity-measurement/hardware/enclosure/stl/fp_top_L.stl

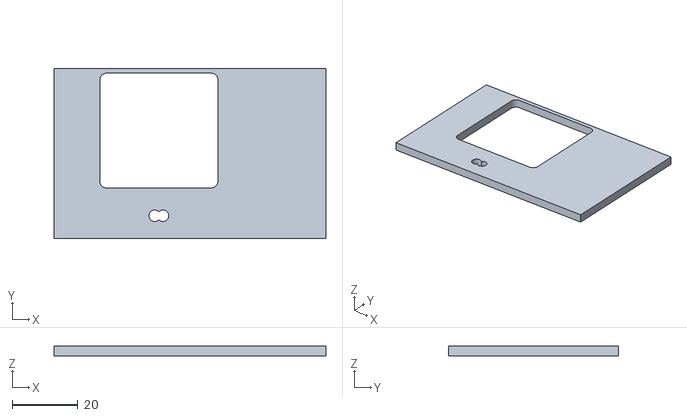
[picture p13: CAD file, 2026-10-17]
hardware/enclosure/stl/fp_top_L.stl
83.0 x 52.0 x 3.00
