wangjiacheng121/pendulum-gravity-measurement/hardware/enclosure/stl/fp_right.stl

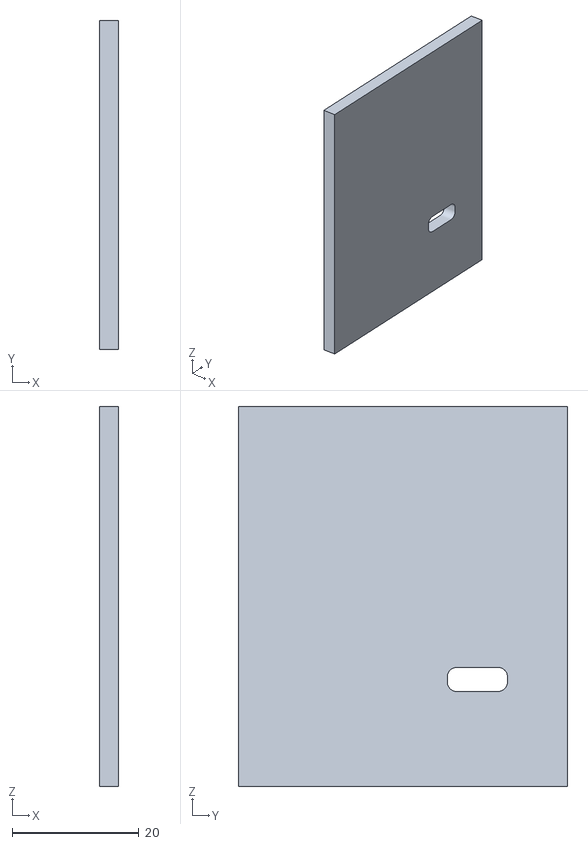
[picture p14: CAD file, 2026-10-17]
hardware/enclosure/stl/fp_right.stl
3.00 x 52.0 x 60.0
