wangjiacheng121/pendulum-gravity-measurement/hardware/enclosure/stl/fp_front_R.stl

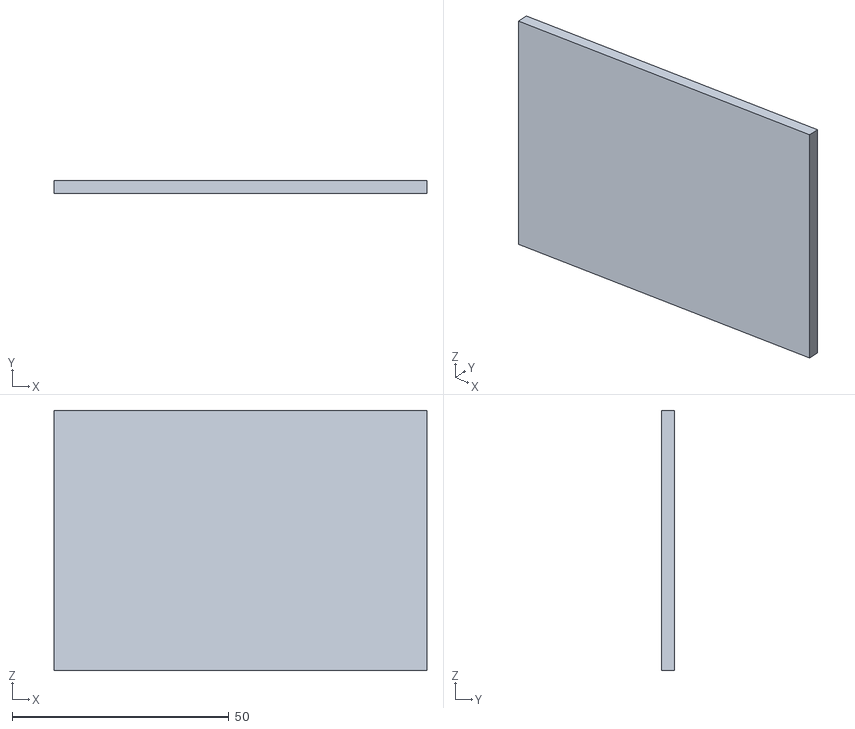
[picture p15: CAD file, 2026-10-17]
hardware/enclosure/stl/fp_front_R.stl
86.0 x 3.00 x 60.0
