wangjiacheng121/pendulum-gravity-measurement/(list of files, cad)

Other CAD files:
hardware/enclosure/stl/fp_left.stl
hardware/enclosure/stl/fp_front_L.stl
hardware/enclosure/stl/fp_bottom_R.stl
hardware/enclosure/stl/fp_bottom_L.stl
hardware/enclosure/stl/fp_back_R.stl
hardware/enclosure/stl/fp_back_L.stl
