wangjiacheng121/pendulum-gravity-measurement/firmware/TaskManagerFirmware/fw_config.h

#pragma once
// =====================================================================
// fw_config.h —— 全局配置（引脚 / 时序常量 / 默认值）
// 依据《00-总纲-架构与硬件协议》
// 注意：天气 Key 改为内置（2026-10-02 用户要求「将 key 写入固件」）。
//       NVS 优先级高于内置值 —— 换账号/换服务只需 BLE [4.4] 覆盖，无需重刷。
// 例外：WiFi「默认回退列表」按用户 2026-09-30 明确要求内置（见下方 WIFI_DEF_*）。
//       这三条属个人私有凭据 —— 若日后公开发布源码/开源仓库，务必先清空！
// =====================================================================

#define FW_VERSION      "1.0.0"
#define FW_NAME         "TaskManagerFirmware"
#define FW_BUILD_DATE   __DATE__ " " __TIME__   // 编译时自动注入构建时间

// ---------- 引脚（总纲第 3 节，实物硬件） ----------
#define PIN_OPTOGATE    4       // 光电门信号（经 BSS138 电平转换，空闲高/遮挡低）
#define PIN_BUTTON      5       // 按键，INPUT_PULLUP，按下=LOW
#define PIN_SDA         8       // I2C SDA
#define PIN_SCL         9       // I2C SCL

// ---------- OLED ----------
#define OLED_ADDR_1     0x3C    // 首选地址（7 位）
#define OLED_ADDR_2     0x3D    // 备用地址

// ---------- 按键时序（总纲第 1 节硬约束） ----------
// 2026-10-02 修订：BTN_LONG_MS 1200→800。
// 原 1.2s 阈值在 loop() 100ms 节拍 + 天气程序 15-25s 阻塞下几乎不可能被采样到，
// 实测长按切程序完全失效。800ms 仍明显长于人手「点一下」的 200-300ms，
// 不会与短按混淆，但长按容错从「几乎做不到」变为「正常可用」。
#define BTN_DEBOUNCE_MS 30      // 软件消抖
#define BTN_LONG_MS     800     // 长按 = 切换程序
#define BTN_SUPER_MS    5000    // 超长按 = 系统重启（预留）

// ---------- 主循环节拍 ----------
// 2026-10-02 拆分两级节拍（长按失效修复）：
//   LOOP_INTERVAL_MS —— loop() 自身节拍，10ms。只为把按键采样率从 10Hz 提到 100Hz：
//                       100ms 采样下一次短按（按下+抬起约 150-250ms）会横跨 2-3 个采样窗，
//                       消抖窗口 30ms 虽能通过，但采样点太少，长按时长判定误差可达 ±100ms。
//   TICK_INTERVAL_MS —— onTick 业务分发节拍，仍为 100ms（≤10Hz，总纲 5.2 契约不变）。
// 二者不可互相替代：onTick 里的 NVS 写入 / 整帧提交 / BLE 分块都是重活，不能提到 100Hz。
#define LOOP_INTERVAL_MS 10
#define TICK_INTERVAL_MS 100    // onTick 分发 ≤10Hz（总纲 5.2 契约）

// ---------- 屏保 / 熄屏（总纲 5.4 省电分级） ----------
#define SCREEN_SAVER_DEFAULT_S 180      // sys.screen_saver_timeout 默认值，0=关闭
#define PET_IDLE_TO_SLEEPY_MS  (5UL*60UL*1000UL)   // 程序1 idle 5min → 瞌睡（L3）
#define PET_SLEEPY_TO_OFF_MS   (60UL*1000UL)       // 瞌睡 1min → 请求熄屏
#define NET_IDLE_DISCONNECT_MS (5UL*60UL*1000UL)   // WiFi 空闲 5min 断开（L2）

// ---------- 默认定位（总纲第 7 节 NVS 表，可经 BLE 修改） ----------
#define LOC_LON_DEFAULT "114.88"        // 张家口一中
#define LOC_LAT_DEFAULT "40.77"

// ---------- 默认 WiFi 回退列表（开源已清空，请填入你自己的网络；见 README） ----------
// 优先级：NVS 用户凭据（BLE 配网 sys.wifi_ssid/pass）> 下方顺序；
// 连接失败（不在范围/认证失败/20s 超时）自动轮换下一个，整轮失败回 IDLE 等外部重试
#define WIFI_CRED_MAX    4              // 列表容量 = 1 条用户凭据 + 3 条默认
// ⚠️ 开源已清空：请改为你自己的 WiFi（或留空，改用 BLE [1.2] 配网写入 NVS）
#define WIFI_DEF_SSID_1  ""
#define WIFI_DEF_PASS_1  ""
#define WIFI_DEF_SSID_2  ""
#define WIFI_DEF_PASS_2  ""
#define WIFI_DEF_SSID_3  ""
#define WIFI_DEF_PASS_3  ""

// ---------- 历史/天气缓存容量 ----------
#define HIST_CAP        50      // app2.hist_00..hist_49 环形区

// ---------- 程序2 单摆测g（分册02） ----------
// 2026-10-03 重大改造：门限从「微秒级」压到「准静态物理级」，采集层零过滤。
// 改造前后的职责划分变了，必须先说清楚，否则又会出现「一个常量管两件事」：
//   采集层（ISR）只做一件事 —— 把 GPIO4 的每一条边沿连同时间戳存进环形队列。
//        零过滤、零丢弃、零门限。亮起和熄灭都被记录，「漏记」在采集层不再可能发生。
//   重建层（onTick）从边沿序列重建「遮挡块 → 过最低点中点」，并在这里做全部纠错：
//        电气尖峰剔除、合并块分裂、丢样恢复、离群删除、系统性倍率纠正。
// 换言之：门限从「决定收不收数据」降级为「决定这条数据算不算一次有效摆动」，
// 两者不再混为一谈。所有原始边沿都可用 EDGES 命令导出核对。
#define GATE_EDGE_RING   1024    // 原始边沿队列深度（2 的幂，ISR 用 & 取模）。
                                  // R7b（2026-10-06）64→1024：实摆光电门信号存在持续振荡
                                  // （实测 75s 灌入 5536 边沿、溢出 3394，突发簇远超 64 深），
                                  // 溢出会把真实摆动边沿一起挤掉 = 「挡光彻底不识别」的元凶。
                                  // RAM 代价 5KB（动态内存余量 272KB，可忽略）。

// 电气尖峰下限：把「微秒级硬件尖峰/振荡碎片段」从重建流程里摘掉。
// R7b（2026-10-06）20µs→200µs：实测振荡环境下 20~200µs 的碎片段仍有大量存活
// （75s 产生 1283 个 <20µs 被剔 + 大量 >20µs 成块），200µs 能把电平转换慢边沿
// 振荡的碎片级翻转全部掐掉。真实遮挡 = 挡光宽度÷过最低点速度，
// 实测 4.7ms（5g 砝码 30°振幅）~ 45ms（15~20mm 硬纸片），对 200µs 有 23 倍裕度。
#define GATE_BLINK_MIN_US    200UL
// —— 宽容模式（R7c，2026-10-06；同日修订：默认启用）——
// R7b 严格门限（BLINK 200µs/STUCK 粘连）在病态信号下会「零产出」：全部片段
// <200µs 被剔 → 0 块 0 样本 → 屏幕无数据（实测：点挡 3s 期间 21 片段全 <200µs）。
// R7c 初版为「30s 零产出自动降级」；用户决策改为**默认即宽容**（实验不允许等待）：
// 片段层常驻宽容值——BLINK 用 GATE_BLINK_MIN_FB_US(20µs，=R7 前旧版值)、
// STUCK 粘连剔除（片段级+合并链级）停用；统计层（相对门限/半样本配对/离群删除）
// 全部保留 = 质量守门员，毛刺假中点由离群删除清理，真摆样本畅通（仿真 S15 实证
// 降级后真摆 G 偏差 +0.00%）。GATE 输出「当前电平/宽容模式」直读行。
// _degraded=true 为常驻状态，将来如需恢复严格模式把 app2_pendulum.h 初值改 false
// 并按 git/R7c 日志恢复触发块。
#define GATE_BLINK_MIN_FB_US  20UL
#define GATE_DEGRADE_REJ      8     // GATE verdict 判「剔除主导」的阈值（rej≥8）
// 相邻中点绝对下限：仅作兜底，正常判定走相对门限（PEND_MINGAP_REL，按 hRef 比例）。
// 半周期 h=π√(L/g)，L 取最小 0.1m 也有 0.63s；2ms 远低于任何物理可能，
// 只用来挡住「同一个块被算出两个中点」这种结构性错误。
#define GATE_MINGAP_US    2000UL
#define GATE_TIMEOUT_US    5000000UL      // >5s 视为基准失效，重置基准不计数

// —— 重建层（onTick）的全部判据，都以「理论/实测半周期 hRef」为标尺 ——
// 片段层合并门限（R7-01，2026-10-06 由 0.30 上调至 0.45）：
//   两次真实过零的片段间隔 = h − 遮挡时长 ≈ 0.9×h，远大于 0.45×h，不会误合并；
//   而「双遮挡」——光路里有两个遮挡物（摆球+挡光片）先后过槽——两块片段的
//   间隔 = Δ − 遮挡时长（Δ ≤ 0.5×h，因两遮挡物间距不可能超过摆长），当 Δ 较小时
//   落在 0.45×h 以内，必须合并成 1 个中点，否则每个真实半周期会产出 2 个假中点，
//   周期被压半 → g 虚增 4 倍（实测定向复现：G=39.3 = 4×9.83）。
//   合并中点 = 两片段按时长加权的几何中心，虽然绝对相位偏移 Δ/2，但「间隔」
//   完全不受影响，对 g 零偏差。
#define PEND_MERGE_REL    0.45
// 粘连块剔除（R7b，2026-10-06 新增）：完整片段时长 > 0.50×hTheo 判「信号粘连/振荡假块」，
// 剔除并计数 _nStuck。实测振荡环境下出现 740ms 的"遮挡块"（真实纸片遮挡仅 15~45ms，
// 是信号贴着阈值慢振荡把 LOW 段拉长数百倍）。物理依据：遮挡时长 = 遮挡宽÷速度，
// 最宽 45mm + 释放起点 3° 的极端组合在 L=0.428m 时也只有 ~154ms，而 0.50×hTheo=328ms，
// 有 2 倍以上裕度；SIM 注入遮挡 = h/20 = 0.05×h，远低于门限。
// 注意：本判据假定 L ≥ 0.4m（本项目实验范围）；L < 0.2m 的大遮挡物慢摆可能被误杀。
#define PEND_STUCK_REL    0.50
// 中点流相对门限：相邻中点差 < 0.30×hTheo 判电气毛刺/抖动，剔除但计数。
// R7-02（2026-10-06）：标尺从 hRef（实测滑均，可被假样本污染）换成 hTheo（理论值，
// 来自 L 与当地 g，恒可靠）。hRef 被污染后用相对门限会「真假一起删」，表现为挡光不计数。
// 半周期是本实验唯一的时间尺度，凡远小于它的都是干扰，没有物理意义。
#define PEND_MINGAP_REL   0.30
// 半样本配对合并（R7-03，2026-10-06 新增）：Δ 较大的双遮挡无法在片段层合并，
// 中点间隔呈 Δ 与 h−Δ 两簇交替（Δ∈(0.45h, 0.8h) 时两簇都保留到中点流）。
// 两簇样本都 < 0.80×hTheo 且彼此之和 ≈ hTheo（±20%）→ 合并为 1 个真样本（时间守恒）；
// 落单的短样本（后继不是短样本 / 和对不上）→ 删除并计数 _nShortDrop。
// 物理约束保证安全：快慢交替的真样本幅度 ≤±8%（都 > 0.8×h，不判短）；
// 两个真样本之和 = 2h ≠ h，天然不满足配对条件。
#define PEND_SHORT_MAX_REL   0.80
#define PEND_SHORT_PAIR_TOL  0.20
// 离群门限：|d − hRef|/hRef > 0.25 判「明显不符合规律」，删除但计数。
// 留 25% 宽容度是因为光电门偏离最低点时相邻半周期会一快一慢（幅度对称），
// 真实数据本身就能有 ±8% 的摆动，必须放得下。
// R7-04（2026-10-06）：去掉「_nHalf>=4 才启用」的门槛 —— 该门槛让开头 4 个样本
// 绕过全部相对判据，双遮挡假中点恰好能在 2 个真实半周期内凑满 4 个 → 污染
// _sumHalf/hRef → 正反馈锁死（真样本反被当离群删除）。hRef 在样本 <3 时本就
// 回退到理论值 hTheo，理论标尺从头到尾可用，无需免检窗口。
#define PEND_OUTLIER_REL  0.25
// 整数倍判定容差：d/hRef 落在整数 k 的 ±8% 内即认定「中间漏掉了 k−1 次」，
// 据此恢复样本计数（时间守恒：sumHalf 加的仍是同一段真实时间，故不污染 g，
// 只修好 n 计数与波形里的真实摆动次数）。
#define PEND_INT_TOL      0.08
// 注：此处曾有 PEND_BLK_SPLIT_RATIO / PEND_SPLIT_MAX 两个「合并块分裂」常量，
// 已随该设计一并删除（详见 app2_pendulum.cpp 碎片合并段的注释与
// tools/selftest_rebuild.py 顶部说明）：那是段永远不触发的死代码，
// 而 LOW 段裂成几片属于「同一次过零的碎片」，应当合并成 1 个中点（PEND_MINGAP_REL 判据）。
// 系统性倍率纠正容差：实测平均周期 / 理论周期 落在整数 m 的 ±10% 内即触发自动纠正。
// 只做单侧（缩小）：丢事件只会让间隔变大，绝不会变小，因此这个方向无歧义；
// 反方向（间隔偏小）在物理上不可能由丢样造成，一律不自动改，只提示检查摆长。
#define PEND_FIX_TOL      0.10
#define PEND_FIX_MAXK     4       // 最多按 4 倍折算（对应「每 4 次漏 1 次」以内）

#define PEND_LEN_DEFAULT   1.000          // app2.pend_len 出厂默认（m）
#define SG_DEFAULT         9.794          // 无缓存时默认标准 g（sg_src=DEFAULT）

// ---------- 程序3 天气（分册03） ----------
// 内置和风天气凭据（2026-10-02 用户要求写入固件，开机即用、无需先配网）
// ⚠️ 个人私有凭据 —— 公开发布源码/开源仓库前务必清空这两行！
//
// Host 请使用你自己在和风天气控制台「设置→凭据管理」获取的账号专属域名
//   （格式如 xxxxx.re.qweatherapi.com，区域码以控制台显示为准）→ 实测 code=200，
//   对应城市实时数据正常，now 与 24h 两接口均通。
// 换账号时无需重刷：BLE [4]→[4.4] 覆盖 NVS 即可（NVS 优先于本值）。
// ⚠️ 开源已清空：请填入你自己的和风天气凭据（或留空，改用 BLE [4]→[4.4] 配置写入 NVS）
#define WX_HOST_DEFAULT ""
#define WX_KEY_DEFAULT  ""
#define WX_PERIOD_MS       (30UL*60UL*1000UL)  // 30 分钟拉取周期
#define WX_RETRY_DELAY_MS  30000UL             // 失败重试间隔（仅重试 1 次）
#define WX_HTTP_TIMEOUT_MS 10000UL             // HTTP 超时 10s

// ---------- 错误码（总纲 8.2 三族；网络族） ----------
#define E_NET_NO_CRED   (-100)   // 未配置凭据
#define E_NET_TIMEOUT   (-101)   // 连接/请求超时
#define E_NET_GZIP      (-102)   // GZIP 解压失败
#define E_WX_PARSE      (-103)   // 天气响应解析失败
#define E_WX_API        (-104)   // 天气 API 返回 code != 200
#define E_WX_HOST       (-105)   // API Host 域名无法解析（2026-10-02 新增：
                                   // 内置 Host 区域码猜错时 httpGet 只回 -1，
                                   // 单独报错才能定位是域名问题而非网络不通。
                                   // 注意 WiFi.hostByName() 对不存在的域名仍返回 true
                                   // 但 IP 为 0.0.0.0 → 必须同时校验 IP 非 0）

// ---------- 事件附加码（Event::code） ----------
#define EVT_NET_LOST_CODE_POWERSAVE 1   // EVT_NET_LOST：L2 空闲主动断电，非故障
                                        // （不标注会让桌宠把「省电断网」误判成掉线而长期 Sad）
