wangjiacheng121/pendulum-gravity-measurement/(commit log)

2026-10-17 add assets/photos/产品实物图.jpg
2026-10-17 add assets/photos/单摆测重力加速度实景.jpg
2026-10-17 add assets/photos/单摆测重力加速度理想数据.jpg
2026-10-17 add assets/photos/单摆测重力加速度理想数据2.jpg
2026-10-17 add assets/photos/天气-温度.jpg
2026-10-17 add assets/photos/天气-降水.jpg
2026-10-17 add assets/photos/天气-风速.jpg
2026-10-17 add assets/photos/桌宠-打盹.jpg
2026-10-17 add docs/design-spec/00-总纲-架构与硬件协议.md
2026-10-17 add docs/design-spec/01-程序1-桌宠.md
2026-10-17 add docs/design-spec/02-程序2-单摆测g-中点法修订补丁.md
2026-10-17 add docs/design-spec/02-程序2-单摆测g.md
2026-10-17 add docs/design-spec/03-程序3-天气.md
2026-10-17 add firmware/TaskManagerFirmware/docs/程序1-桌宠.md
2026-10-17 add firmware/TaskManagerFirmware/docs/程序2-单摆测g.md
2026-10-17 add firmware/TaskManagerFirmware/docs/程序3-天气.md
2026-10-17 add firmware/TaskManagerFirmware/tools/启动服务.bat
2026-10-17 add firmware/TaskManagerFirmware/tools/电脑端使用说明.txt
2026-10-17 add hardware/3D打印外壳图纸（嘉立创X树脂免费打样）.html
2026-10-17 add hardware/enclosure/model_enclosure.py
2026-10-17 add hardware/enclosure/stl/fp_back_L.stl
    [fp_back_L.stl]
2026-10-17 add hardware/enclosure/stl/fp_back_R.stl
    [fp_back_R.stl]
2026-10-17 add hardware/enclosure/stl/fp_bottom_L.stl
    [fp_bottom_L.stl]
2026-10-17 add hardware/enclosure/stl/fp_bottom_R.stl
    [fp_bottom_R.stl]
2026-10-17 add hardware/enclosure/stl/fp_front_L.stl
    [fp_front_L.stl]
2026-10-17 add hardware/enclosure/stl/fp_front_R.stl
    [fp_front_R.stl]
2026-10-17 add hardware/enclosure/stl/fp_left.stl
    [fp_left.stl]
2026-10-17 add hardware/enclosure/stl/fp_right.stl
    [fp_right.stl]
2026-10-17 add hardware/enclosure/stl/fp_top_L.stl
    [fp_top_L.stl]
2026-10-17 add hardware/enclosure/stl/fp_top_R.stl
    [fp_top_R.stl]
2026-10-17 add hardware/enclosure/stl/shell_assembled.stl
    [shell_assembled.stl]
2026-10-17 add hardware/enclosure/stl/shell_left_tray.stl
    [shell_left_tray.stl]
2026-10-17 add hardware/enclosure/stl/shell_right_tray.stl
    [shell_right_tray.stl]
2026-10-17 add hardware/单摆测g面包板逐孔接线详解.html
2026-10-17 add tools/mobile-webui/使用说明.txt
2026-10-17 add tools/mobile-webui/启动服务.sh
2026-10-17 add tools/pc-webui/启动服务.bat
2026-10-17 add tools/pc-webui/电脑端使用说明.txt
